konkers/lithe/README.md

# lithe
A joystick/game controller firmware.
