konkers/lithe/pcb/lithe-pcb.pdf

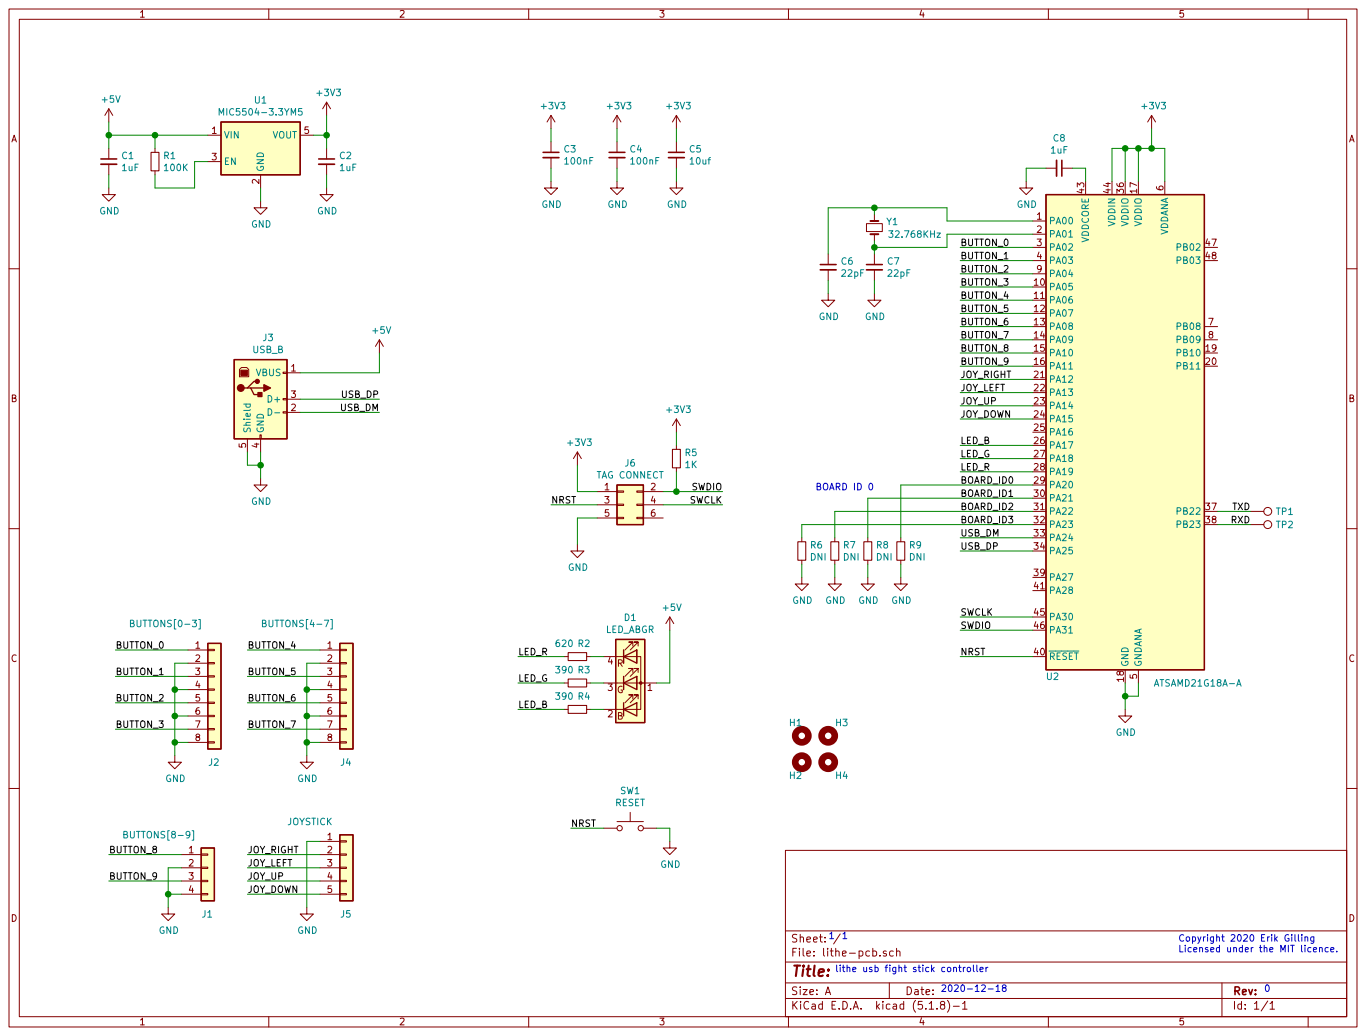
[picture p1: page 1]

Licensed under the MIT licence. 2020-12-18 1 1

lithe usb fight stick controller
