konkers/lithe/pcb/lithe-pcb.kicad_pcb

## KiCad design pcb/lithe-pcb.kicad_pcb (2020-12-20)

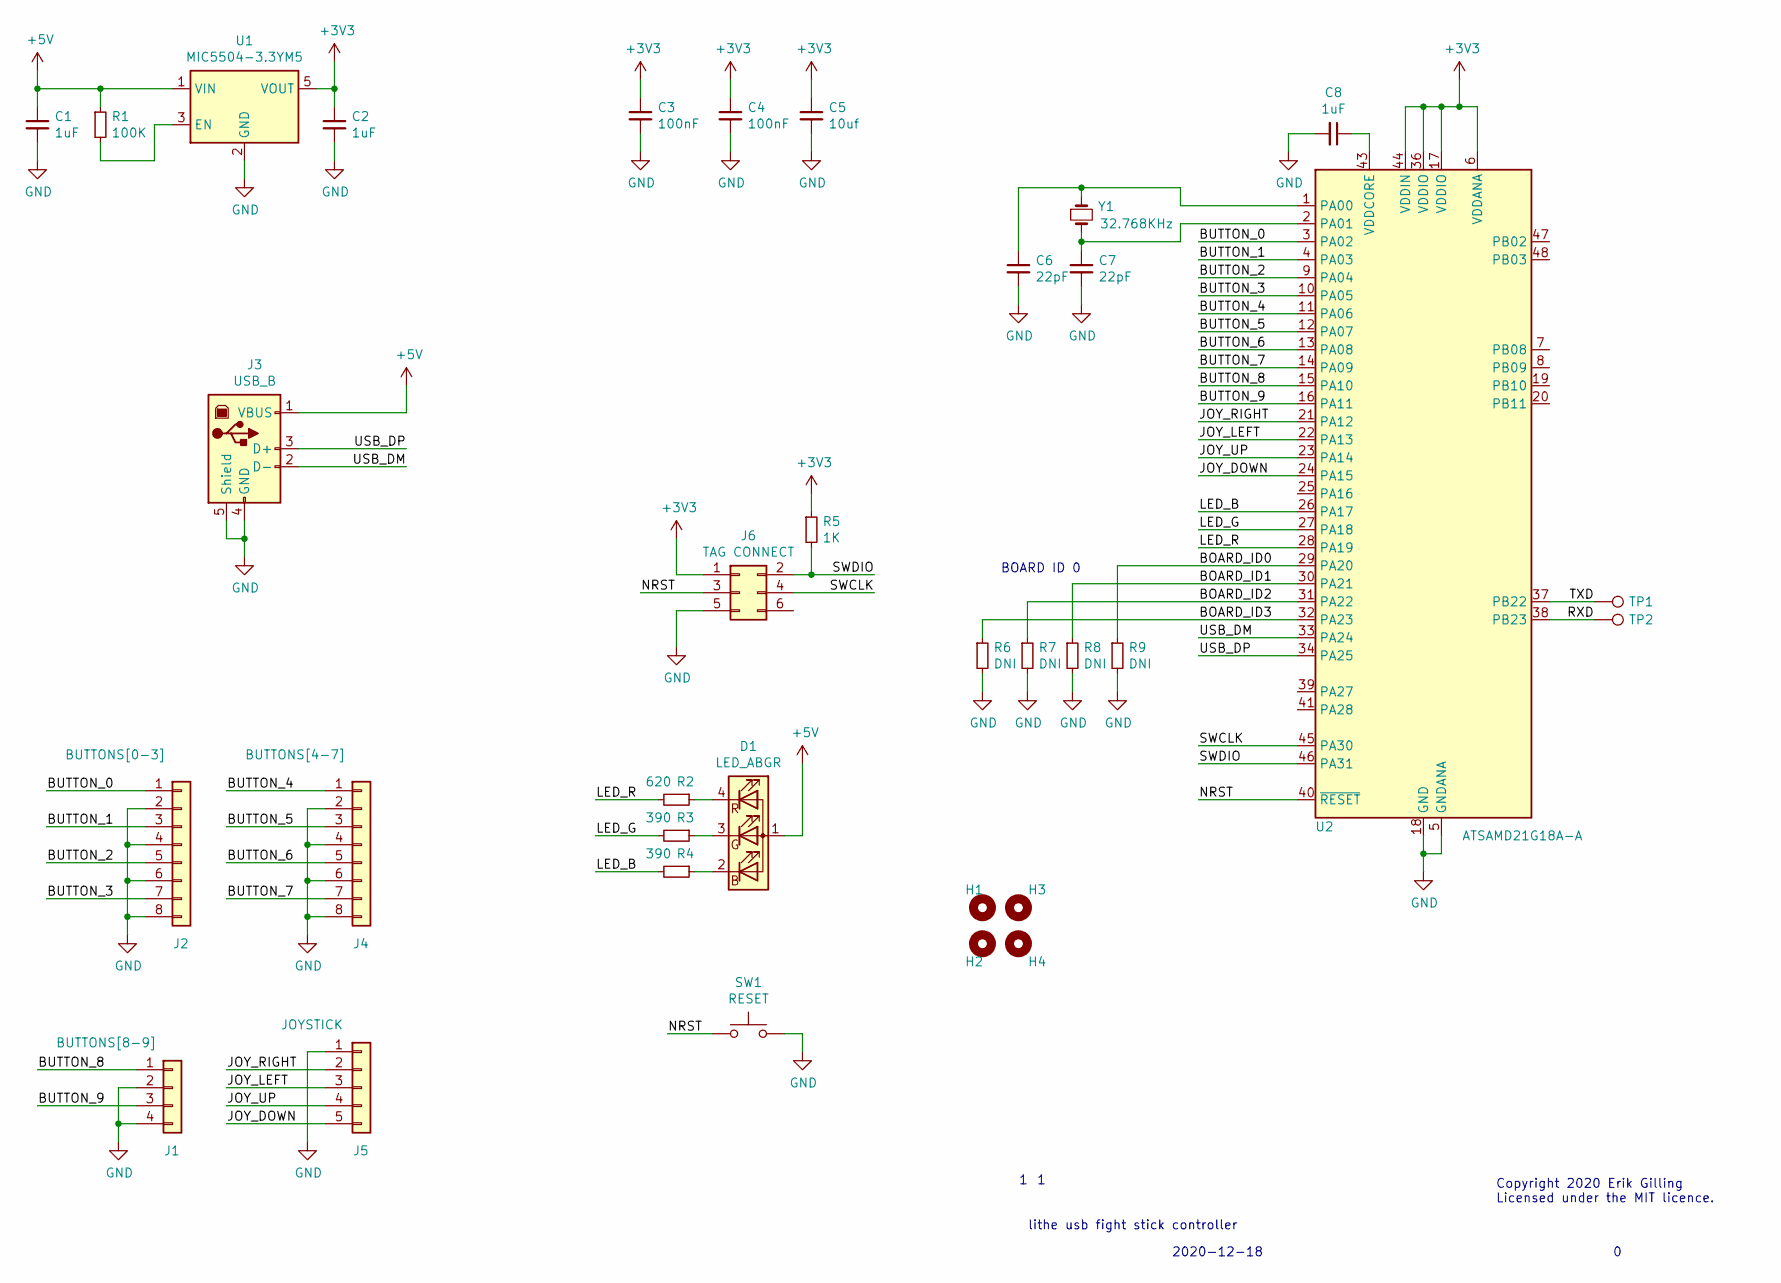
[picture p2: schematic lithe-pcb.sch]

Parts:
C1, C2, C8: 1uF; C_0402_1005Metric; DIGI_PN 1276-6524-2-ND
C3, C4: 100nF; C_0402_1005Metric; DIGI_PN 311-2077-1-ND
C5: 10uf; C_0603_1608Metric; DIGI_PN 490-3298-1-ND
C6, C7: 22pF; C_0402_1005Metric; DIGI_PN 445-1239-1-ND
D1: LED_ABGR; LED_Cree-PLCC4_2x2mm_CW; DIGI_PN CLMVC-FKA-CL1D1L71BB7C3C3TR-ND
H1, H2, H3, H4: MountingHole; MountingHole_3.2mm_M3_ISO7380
J1: BUTTONS[8-9]; PhoenixContact_MCV_1,5_4-G-3.5_1x04_P3.50mm_Vertical; DIGI_PN 277-5738-ND
J2: BUTTONS[0-3]; PhoenixContact_MCV_1,5_8-G-3.5_1x08_P3.50mm_Vertical; DIGI_PN 277-5759-ND
J3: USB_B; USB_B_Lumberg_2411_02_Horizontal
J4: BUTTONS[4-7]; PhoenixContact_MCV_1,5_8-G-3.5_1x08_P3.50mm_Vertical; DIGI_PN 277-5759-ND
J5: JOYSTICK; PhoenixContact_MCV_1,5_5-G-3.5_1x05_P3.50mm_Vertical; DIGI_PN 277-5752-ND
J6: TAG CONNECT; Tag-Connect_TC2030-IDC-NL_2x03_P1.27mm_Vertical
R1: 100K; R_0402_1005Metric; DIGI_PN YAG2307TR-ND
R2: 620; R_0402_1005Metric; DIGI_PN 311-620LRTR-ND
R3, R4: 390; R_0402_1005Metric; DIGI_PN 311-390LRTR-ND
R5: 1K; R_0402_1005Metric; DIGI_PN 311-1.00KLRTR-ND
R6, R7, R8, R9: DNI; R_0402_1005Metric; DIGI_PN 311-0.0JRTR-ND
SW1: RESET; SW_SPST_EVQPE1; DIGI_PN CKN12311-2-ND
TP1, TP2: TestPoint; TestPoint_Pad_D1.0mm
U1: MIC5504-3.3YM5; SOT-23-5; DIGI_PN MIC5504-3.3YM5-T5TR-ND
U2: ATSAMD21G18A-A; TQFP-48_7x7mm_P0.5mm; DIGI_PN ATSAMD21G18A-AU-ND
Y1: 32.768KHz; Crystal_SMD_MicroCrystal_CC7V-T1A-2Pin_3.2x1.5mm_HandSolder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; DIGI_PN 2195-CM7VT1ALOWESR32.768KHZ12.5PF20TAQC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

Connections:
+3V3: C2.1, C3.1, C4.1, C5.1, J6.1, R5.1, U1.5 (VOUT), U2.6 (VDDANA), U2.17 (VDDIO), U2.36 (VDDIO), U2.44 (VDDIN)
+5V: C1.1, D1.1 (A), J3.1 (VBUS), R1.1, U1.1 (VIN)
/BOARD_ID0: R9.1, U2.29 (PA20)
/BOARD_ID1: R8.1, U2.30 (PA21)
/BOARD_ID2: R7.1, U2.31 (PA22)
/BOARD_ID3: R6.1, U2.32 (PA23)
/BUTTON_0: J2.1, U2.3 (PA02)
/BUTTON_1: J2.3, U2.4 (PA03)
/BUTTON_2: J2.5, U2.9 (PA04)
/BUTTON_3: J2.7, U2.10 (PA05)
/BUTTON_4: J4.1, U2.11 (PA06)
/BUTTON_5: J4.3, U2.12 (PA07)
/BUTTON_6: J4.5, U2.13 (PA08)
/BUTTON_7: J4.7, U2.14 (PA09)
/BUTTON_8: J1.1, U2.15 (PA10)
/BUTTON_9: J1.3, U2.16 (PA11)
/JOY_DOWN: J5.5, U2.24 (PA15)
/JOY_LEFT: J5.3, U2.22 (PA13)
/JOY_RIGHT: J5.2, U2.21 (PA12)
/JOY_UP: J5.4, U2.23 (PA14)
/LED_B: R4.2, U2.26 (PA17)
/LED_G: R3.2, U2.27 (PA18)
/LED_R: R2.2, U2.28 (PA19)
/NRST: J6.3, SW1.1, U2.40 (~RESET)
/RXD: TP2.1, U2.38 (PB23)
/SWCLK: J6.4, U2.45 (PA30)
/SWDIO: J6.2, R5.2, U2.46 (PA31)
/TXD: TP1.1, U2.37 (PB22)
/USB_DM: J3.2 (D-), U2.33 (PA24)
/USB_DP: J3.3 (D+), U2.34 (PA25)
GND: C1.2, C2.2, C3.2, C4.2, C5.2, C6.2, C7.2, C8.2, J1.2, J1.4, J2.2, J2.4, J2.6, J2.8, J3.4 (GND), J3.5 (Shield), J4.2, J4.4, J4.6, J4.8, J5.1, J6.5, R6.2, R7.2, R8.2, R9.2, SW1.2, U1.2 (GND), U2.5 (GNDANA), U2.18 (GND), U2.35 (GND), U2.42 (GND)
unnamed: C6.1, U2.1 (PA00), Y1.1
unnamed: C7.1, U2.2 (PA01), Y1.2
unnamed: C8.1, U2.43 (VDDCORE)
unnamed: D1.2 (BK), R4.1
unnamed: D1.3 (GK), R3.1
unnamed: D1.4 (RK), R2.1
unnamed: R1.2, U1.3 (EN)

Notes on the sheet:
lithe usb fight stick controller
2020-12-18
Copyright 2020 Erik Gilling Licensed under the MIT licence.
BOARD ID 0

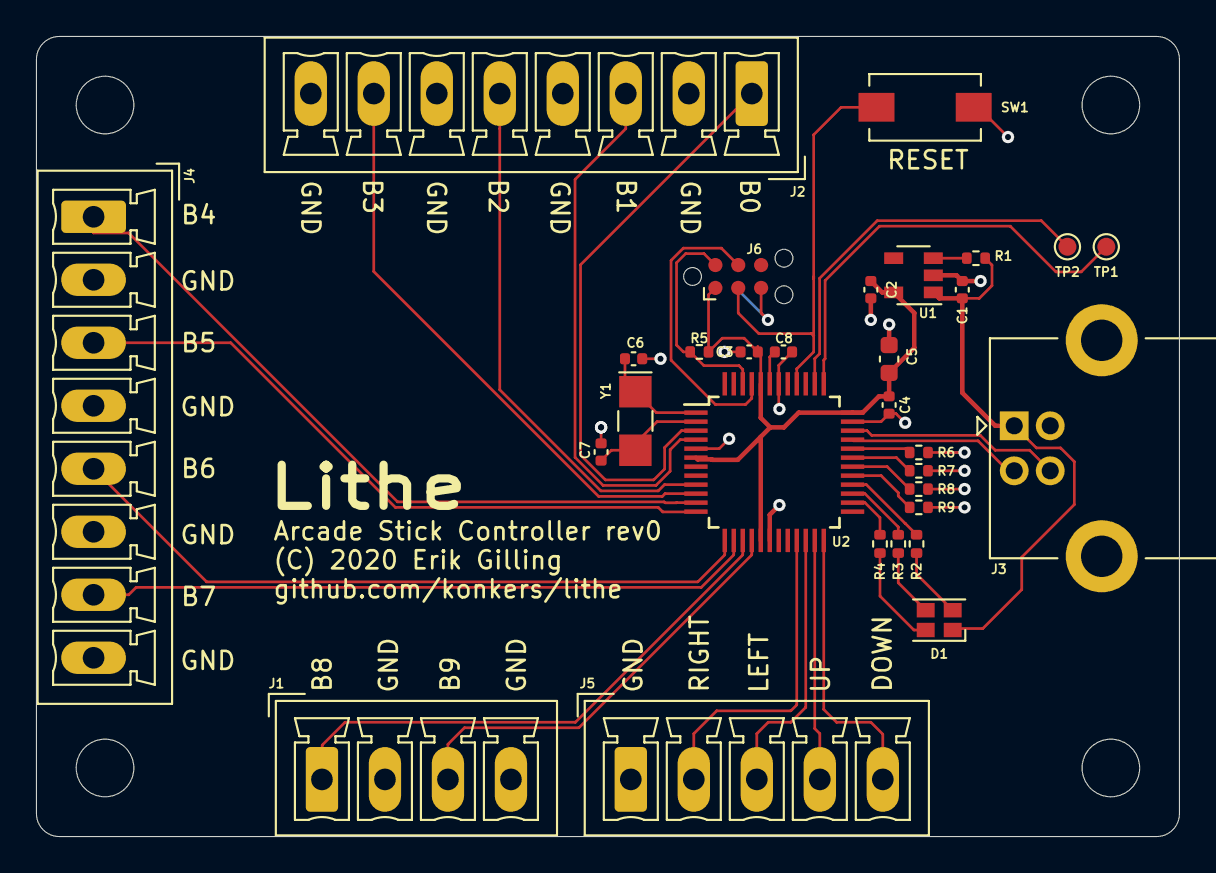
[picture p3: board lithe-pcb.kicad_pcb from above]

Board: 2 copper layers, 63.5 x 44.5 mm, 34 parts (0 on the bottom side), 38 nets.
