konkers/lithe/(commit log)

2020-12-08 Add stub stm32f071-disco target
2020-12-09 Prototype of USB joystick.
2020-12-14 Add samd21 prototype.
2020-12-16 Move common code to lithe library.
    - Extract pin interpretation and USB device into lithe library.
    - Update samd21-mini to use lithe library.
    - Add buttons to samd21-mini.
    - Fix pin definitions for samd21-mini.
    [main.rs]
2020-12-16 Update stm32f072-disco to use lithe library
    Untested on HW.
2020-12-19 [pcb] Add rev0 of PCB.
    [lithe-pcb.kicad_pcb, lithe-pcb.sch]
2020-12-20 [samd21] Add scope trace outputs.
    Add gpio outputs to signal when the timer and usb interrupts are
    active. This can be used to inspect timmings on an oscilliscope.
2020-12-20 [lithe] Use allocated VID/PID from pid.codes.
    https://pid.codes/1209/EEEE/
2020-12-20 [pcb] Annoate parts with DigiKey P/Ns and add BOM.
    [lithe-pcb.kicad_pcb, lithe-pcb.sch, lithe-pcb_bom_.csv]
