konkers/lithe/(notices)

Notices in the files:
pcb/lithe-pcb.kicad_pcb:
(C) 2020 Erik Gilling
